MOUNAlae/dai-comp-001-duct-air-inlet/images/03_demi_coquille_upper.png

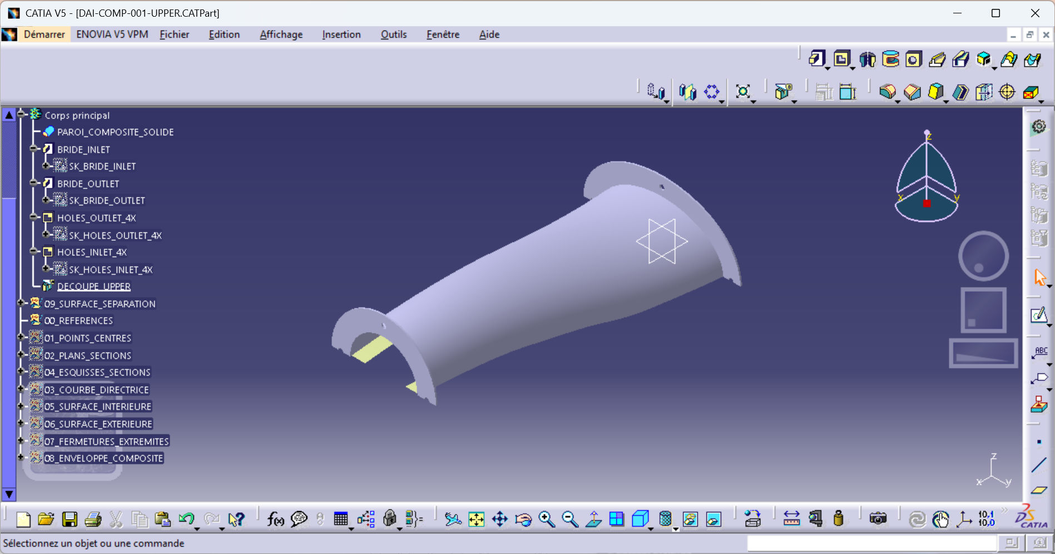
images/03_demi_coquille_upper.png
