MOUNAlae/dai-comp-001-duct-air-inlet/images/04_demi_coquille_lower.png

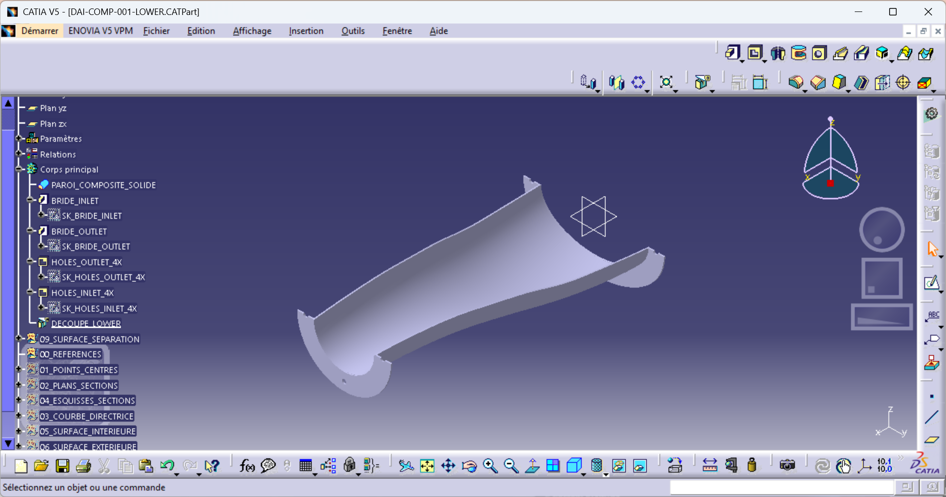
images/04_demi_coquille_lower.png
