MOUNAlae/dai-comp-001-duct-air-inlet/images/06_controle_interferences.png

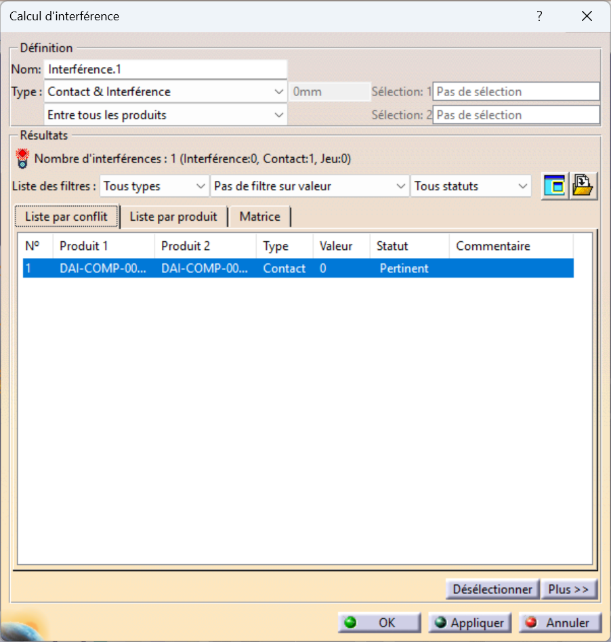
images/06_controle_interferences.png
