MOUNAlae/dai-comp-001-duct-air-inlet/images/07_mise_en_plan_generale.png

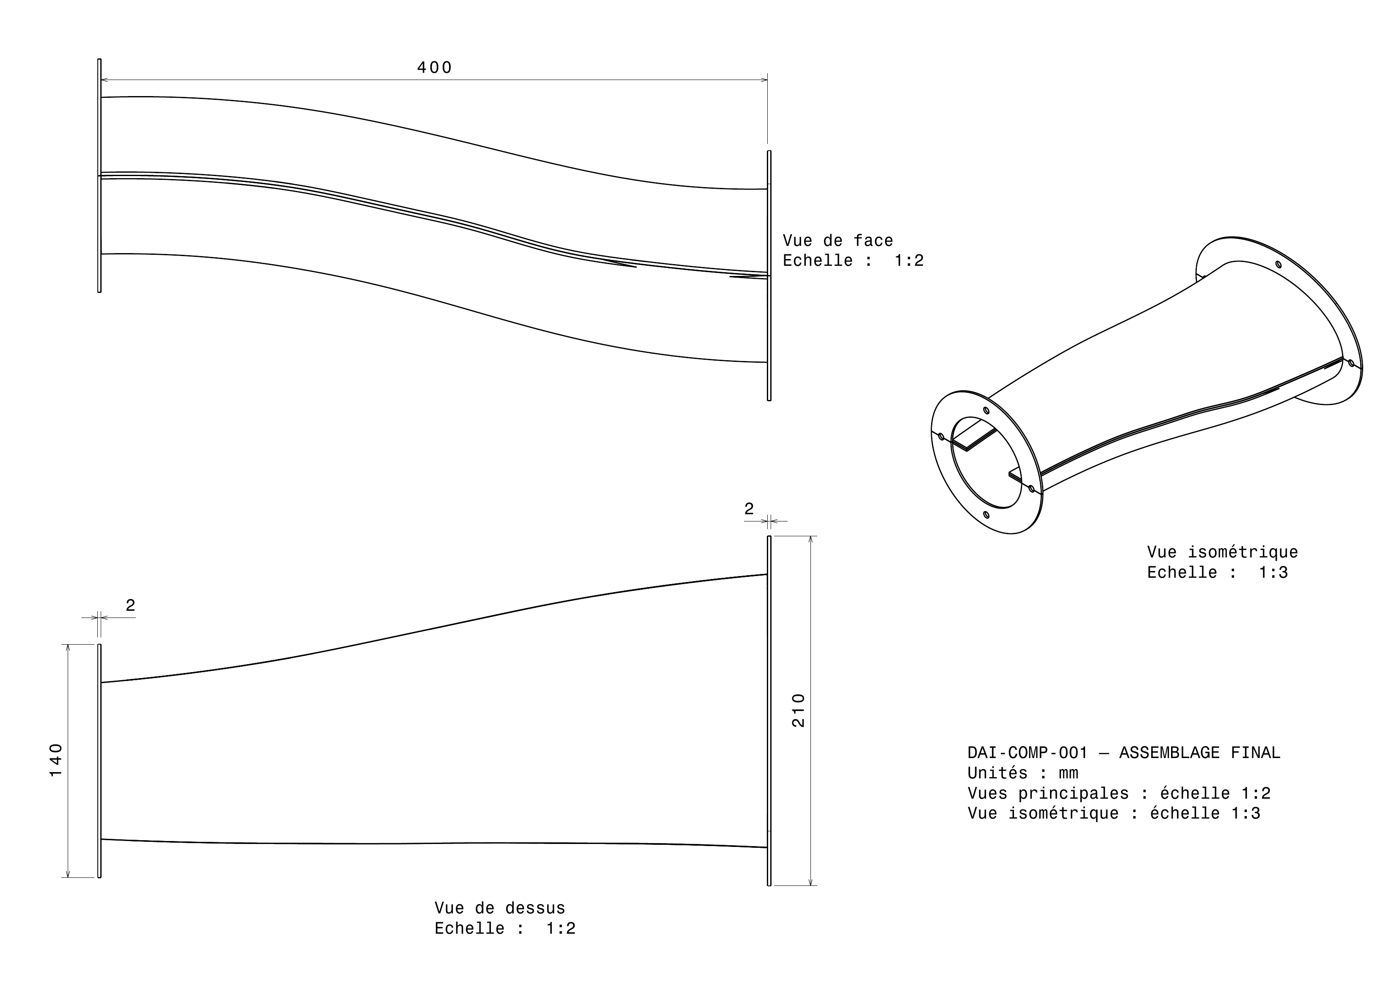
images/07_mise_en_plan_generale.png
