MOUNAlae/dai-comp-001-duct-air-inlet/quality-data/results/DAI_COMP_001_Analyse_Qualite_Final.xlsx

Sheet: 01_PARAMETRES
CODE_PARAMETRE | PARAMETRE | VALEUR | UNITE_OU_COMMENTAIRE
PROJET_ID | Identifiant du projet | DAI-COMP-001 | -
TYPE_DONNEES | Type de données | Synthétiques | Hypothèses pédagogiques
ARCHITECTURE | Architecture du conduit | Deux demi-coquilles UPPER et LOWER | Assemblées par collage
LONGUEUR | Longueur du conduit | 400 | mm
ENTREE_GRAND_AXE | Grand axe de l’entrée | 160 | mm
ENTREE_PETIT_AXE | Petit axe de l’entrée | 100 | mm
SORTIE_DIAMETRE | Diamètre de sortie | 90 | mm
EPAISSEUR_NOMINALE | Épaisseur nominale | 2 | mm
EPAISSEUR_TOLERANCE | Tolérance sur l’épaisseur | 0.2 | mm
PLANEITE_ENTREE_MAX | Planéité maximale de la bride d’entrée | 0.5 | mm
PLANEITE_SORTIE_MAX | Planéité maximale de la bride de sortie | 0.4 | mm
NB_TROUS_INTERFACE | Nombre de trous par interface | 4 | trous
DIAMETRE_TROU | Diamètre nominal des trous | 6.5 | mm
STRATIFICATION | Séquence de stratification | [0/+45/-45/90]s | -
NB_PLIS | Nombre nominal de plis | 8 | plis
NB_JOINTS_LONGITUDINAUX | Nombre de joints longitudinaux | 2 | Joints continus
ECART_PROFIL_MAX_TOLERANCE | Écart maximal admissible du profil intérieur | 1 | mm - hypothèse pédagogique
ECART_POSITION_TROUS_MAX_TOLERANCE | Écart maximal admissible de position des trous | 0.5 | mm - hypothèse pédagogique
PRESSION_TEST_ETANCHEITE | Pression du test pédagogique d’étanchéité | 20 | kPa
DUREE_TEST_ETANCHEITE | Durée du test pédagogique d’étanchéité | 60 | s
TAUX_FUITE_MAX | Indice maximal pédagogique de fuite | 0.5 | kPa/min
DEFINITION_TAUX_FUITE | Définition de l’indice de fuite | Chute de pression équivalente par minute | Méthode pédagogique non industrielle

Sheet: 02_DATASET
ID_PIECE | ORDRE_PRODUCTION | SCENARIO | DATE_FABRICATION | ID_UPPER | ID_LOWER | LOT_PREIMPREGNE | LOT_ADHESIF | MOULE_UPPER | MOULE_LOWER | OPERATEUR_DRAPAGE | OPERATEUR_ASSEMBLAGE | CYCLE_CUISSON | PRESSION_VIDE_ABS_MBAR | TEMP_MAX_C | TEMPS_MAINTIEN_MIN | TEMP_DEMOULAGE_C | RATIO_ADHESIF | TEMPS_OUVERT_MIN | EPAISSEUR_MOY_MM | PLANEITE_ENTREE_MM | PLANEITE_SORTIE_MM | DIAMETRE_TROU_MOY_MM | ECART_PROFIL_MAX_MM | ECART_POSITION_TROUS_MAX_MM | PRESSION_TEST_KPA | DUREE_TEST_S | TAUX_FUITE | JOINT_CONTINU_CONFORME | DEFAUT_PRINCIPAL | NB_DEFAUTS | STATUT_FINAL | COMMENTAIRE
DAI-0001 | 1 | INITIAL | 2026-01-05 | UP-0001 | LO-0001 | PRE-01 | ADH-01 | MU-01 | ML-01 | OP-D01 | OP-A01 | CYC-001 | 100.8 | 122.4 | 87.6 | 64.4 | 1.013 | 42.4 | 2.11 | 0.38 | 0.38 | 6.57 | 0.64 | 0.31 | 20 | 60 | 0.38 | OUI | AUCUN | 0 | CONFORME
DAI-0002 | 2 | INITIAL | 2026-01-06 | UP-0002 | LO-0002 | PRE-01 | ADH-01 | MU-02 | ML-02 | OP-D02 | OP-A02 | CYC-001 | 113.7 | 121.8 | 88.4 | 66.4 | 0.993 | 28.2 | 1.81 | 0.54 | 0.46 | 6.51 | 0.57 | 0.34 | 20 | 60 | 0.26 | OUI | VIDE_POROSITE | 1 | NON CONFORME | Critères hors limite : PLANEITE
DAI-0003 | 3 | INITIAL | 2026-01-07 | UP-0003 | LO-0003 | PRE-01 | ADH-01 | MU-01 | ML-01 | OP-D03 | OP-A01 | CYC-001 | 111.6 | 120.3 | 95.3 | 58.4 | 0.962 | 35.1 | 1.98 | 0.39 | 0.26 | 6.51 | 0.65 | 0.23 | 20 | 60 | 0.57 | OUI | ETANCHEITE | 1 | NON CONFORME | Critères hors limite : ETANCHEITE
DAI-0004 | 4 | INITIAL | 2026-01-08 | UP-0004 | LO-0004 | PRE-01 | ADH-01 | MU-02 | ML-02 | OP-D01 | OP-A02 | CYC-001 | 99 | 119.3 | 93.2 | 61 | 1.002 | 32.3 | 1.87 | 0.29 | 0.37 | 6.5 | 0.89 | 0.33 | 20 | 60 | 0.24 | OUI | AUCUN | 0 | CONFORME
DAI-0005 | 5 | INITIAL | 2026-01-09 | UP-0005 | LO-0005 | PRE-01 | ADH-01 | MU-01 | ML-01 | OP-D02 | OP-A01 | CYC-001 | 111.9 | 123.9 | 96.5 | 64.5 | 0.994 | 35.1 | 1.93 | 0.48 | 0.38 | 6.61 | 0.81 | 0.09 | 20 | 60 | 0.53 | NON | COLLAGE | 2 | NON CONFORME | Critères hors limite : ETANCHEITE, COLLAGE
DAI-0006 | 6 | INITIAL | 2026-01-10 | UP-0006 | LO-0006 | PRE-01 | ADH-01 | MU-02 | ML-02 | OP-D03 | OP-A02 | CYC-002 | 130 | 122.2 | 96.7 | 58.1 | 0.998 | 21.9 | 2.1 | 0.53 | 0.39 | 6.46 | 0.77 | 0.17 | 20 | 60 | 0.27 | OUI | VIDE_POROSITE | 1 | NON CONFORME | Critères hors limite : PLANEITE
DAI-0007 | 7 | INITIAL | 2026-01-11 | UP-0007 | LO-0007 | PRE-01 | ADH-01 | MU-01 | ML-01 | OP-D01 | OP-A01 | CYC-002 | 114.8 | 121.8 | 94.2 | 58.8 | 1.044 | 36.2 | 2.09 | 0.43 | 0.27 | 6.51 | 0.62 | 0.25 | 20 | 60 | 0.45 | OUI | AUCUN | 0 | CONFORME
DAI-0008 | 8 | INITIAL | 2026-01-12 | UP-0008 | LO-0008 | PRE-01 | ADH-01 | MU-02 | ML-02 | OP-D02 | OP-A02 | CYC-002 | 88.8 | 121.6 | 87.2 | 55.7 | 0.981 | 35.1 | 1.97 | 0.34 | 0.27 | 6.52 | 0.65 | 0.38 | 20 | 60 | 0.44 | OUI | AUCUN | 0 | CONFORME
DAI-0009 | 9 | INITIAL | 2026-01-13 | UP-0009 | LO-0009 | PRE-01 | ADH-01 | MU-01 | ML-01 | OP-D03 | OP-A01 | CYC-002 | 106.8 | 121.7 | 86.9 | 64.1 | 1.03 | 23.5 | 1.91 | 0.53 | 0.38 | 6.47 | 0.84 | 0.21 | 20 | 60 | 0.43 | OUI | PLANEITE | 1 | NON CONFORME | Critères hors limite : PLANEITE
DAI-0010 | 10 | INITIAL | 2026-01-14 | UP-0010 | LO-0010 | PRE-01 | ADH-01 | MU-02 | ML-02 | OP-D01 | OP-A02 | CYC-002 | 130 | 118 | 94.7 | 54.5 | 0.999 | 29.3 | 1.99 | 0.48 | 0.21 | 6.45 | 0.91 | 0.26 | 20 | 60 | 0.18 | OUI | AUCUN | 0 | CONFORME
DAI-0011 | 11 | INITIAL | 2026-01-15 | UP-0011 | LO-0011 | PRE-01 | ADH-01 | MU-01 | ML-01 | OP-D02 | OP-A01 | CYC-003 | 105.2 | 121.2 | 91.2 | 60.8 | 1.027 | 40.2 | 2.01 | 0.35 | 0.33 | 6.44 | 0.62 | 0.14 | 20 | 60 | 0.53 | OUI | ETANCHEITE | 1 | NON CONFORME | Critères hors limite : ETANCHEITE
DAI-0012 | 12 | INITIAL | 2026-01-16 | UP-0012 | LO-0012 | PRE-01 | ADH-01 | MU-02 | ML-02 | OP-D03 | OP-A02 | CYC-003 | 97.7 | 122.9 | 93.3 | 63.7 | 0.967 | 35.6 | 2.1 | 0.33 | 0.37 | 6.56 | 0.46 | 0.29 | 20 | 60 | 0.69 | NON | COLLAGE | 2 | NON CONFORME | Critères hors limite : ETANCHEITE, COLLAGE
DAI-0013 | 13 | INITIAL | 2026-01-17 | UP-0013 | LO-0013 | PRE-01 | ADH-01 | MU-01 | ML-01 | OP-D01 | OP-A01 | CYC-003 | 104 | 120.8 | 86.3 | 52.4 | 1.013 | 36.7 | 1.88 | 0.33 | 0.24 | 6.56 | 0.75 | 0.27 | 20 | 60 | 0.21 | OUI | AUCUN | 0 | CONFORME
DAI-0014 | 14 | INITIAL | 2026-01-18 | UP-0014 | LO-0014 | PRE-01 | ADH-01 | MU-02 | ML-02 | OP-D02 | OP-A02 | CYC-003 | 102.3 | 122.6 | 93.4 | 65.4 | 0.984 | 37.7 | 1.89 | 0.45 | 0.33 | 6.53 | 0.73 | 0.39 | 20 | 60 | 0.61 | NON | COLLAGE | 2 | NON CONFORME | Critères hors limite : ETANCHEITE, COLLAGE
DAI-0015 | 15 | INITIAL | 2026-01-19 | UP-0015 | LO-0015 | PRE-01 | ADH-01 | MU-01 | ML-01 | OP-D03 | OP-A01 | CYC-003 | 117 | 122.3 | 96.9 | 61.2 | 0.953 | 25.1 | 1.89 | 0.33 | 0.41 | 6.49 | 0.67 | 0.31 | 20 | 60 | 0.49 | OUI | VIDE_POROSITE | 1 | NON CONFORME | Critères hors limite : PLANEITE
DAI-0016 | 16 | INITIAL | 2026-01-20 | UP-0016 | LO-0016 | PRE-01 | ADH-01 | MU-02 | ML-02 | OP-D01 | OP-A02 | CYC-004 | 89.3 | 120.2 | 90.8 | 63.5 | 0.97 | 24.1 | 2.17 | 0.37 | 0.37 | 6.49 | 0.43 | 0.4 | 20 | 60 | 0.49 | OUI | AUCUN | 0 | CONFORME
DAI-0017 | 17 | INITIAL | 2026-01-21 | UP-0017 | LO-0017 | PRE-01 | ADH-01 | MU-01 | ML-01 | OP-D02 | OP-A01 | CYC-004 | 100.6 | 119.5 | 86.6 | 70 | 0.986 | 35.9 | 2.05 | 0.55 | 0.23 | 6.53 | 0.74 | 0.19 | 20 | 60 | 0.61 | OUI | ETANCHEITE | 2 | NON CONFORME | Critères hors limite : PLANEITE, ETANCHEITE
DAI-0018 | 18 | INITIAL | 2026-01-22 | UP-0018 | LO-0018 | PRE-01 | ADH-01 | MU-02 | ML-02 | OP-D03 | OP-A02 | CYC-004 | 109.2 | 123.3 | 90.7 | 62.4 | 1.024 | 32.7 | 1.88 | 0.52 | 0.28 | 6.46 | 0.71 | 0.05 | 20 | 60 | 0.28 | OUI | PLANEITE | 1 | NON CONFORME | Critères hors limite : PLANEITE
DAI-0019 | 19 | INITIAL | 2026-01-23 | UP-0019 | LO-0019 | PRE-01 | ADH-01 | MU-01 | ML-01 | OP-D01 | OP-A01 | CYC-004 | 115.3 | 121.4 | 87.6 | 65.9 | 1.004 | 28.6 | 1.92 | 0.48 | 0.38 | 6.51 | 0.8 | 0.28 | 20 | 60 | 0.16 | OUI | AUCUN | 0 | CONFORME
DAI-0020 | 20 | INITIAL | 2026-01-24 | UP-0020 | LO-0020 | PRE-01 | ADH-01 | MU-02 | ML-02 | OP-D02 | OP-A02 | CYC-004 | 105.1 | 120.5 | 98.7 | 60.6 | 0.994 | 31.5 | 1.99 | 0.26 | 0.31 | 6.62 | 0.44 | 0.21 | 20 | 60 | 0.39 | OUI | AUCUN | 0 | CONFORME
DAI-0021 | 21 | INITIAL | 2026-01-25 | UP-0021 | LO-0021 | PRE-02 | ADH-01 | MU-01 | ML-01 | OP-D03 | OP-A01 | CYC-005 | 89.5 | 122.5 | 92.6 | 56.7 | 0.979 | 32.4 | 2.1 | 0.36 | 0.25 | 6.48 | 0.44 | 0.19 | 20 | 60 | 0.45 | OUI | AUCUN | 0 | CONFORME
DAI-0022 | 22 | INITIAL | 2026-01-26 | UP-0022 | LO-0022 | PRE-02 | ADH-01 | MU-02 | ML-02 | OP-D01 | OP-A02 | CYC-005 | 96.3 | 122.6 | 90.5 | 62.9 | 0.995 | 33.4 | 2.1 | 0.46 | 0.26 | 6.55 | 1 | 0.22 | 20 | 60 | 0.35 | OUI | AUCUN | 0 | CONFORME
DAI-0023 | 23 | INITIAL | 2026-01-27 | UP-0023 | LO-0023 | PRE-02 | ADH-01 | MU-01 | ML-01 | OP-D02 | OP-A01 | CYC-005 | 96.8 | 123.8 | 85 | 50 | 1.007 | 32.5 | 1.95 | 0.27 | 0.26 | 6.49 | 0.93 | 0.41 | 20 | 60 | 0.35 | OUI | AUCUN | 0 | CONFORME
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
DAI-0100 | 100 | AMELIORE | 2026-04-14 | UP-0100 | LO-0100 | PRE-05 | ADH-04 | MU-02 | ML-02 | OP-D01 | OP-A02 | CYC-020 | 65 | 120.6 | 88.2 | 53.1 | 0.991 | 24.3 | 1.96 | 0.27 | 0.2 | 6.5 | 0.39 | 0.22 | 20 | 60 | 0.05 | OUI | AUCUN | 0 | CONFORME

Sheet: 03_DICTIONNAIRE
NOM_VARIABLE | DESCRIPTION | TYPE_DONNEE | UNITE_OU_FORMAT | REGLE_OU_VALEURS
ID_PIECE | Identifiant unique du conduit | Texte | DAI-0001, DAI-0002... | Unique et obligatoire
ORDRE_PRODUCTION | Ordre chronologique de fabrication | Entier | 1, 2, 3... | Strictement positif
SCENARIO | État du procédé | Texte | INITIAL ou AMELIORE | Valeur contrôlée
DATE_FABRICATION | Date pédagogique de fabrication | Date | JJ/MM/AAAA | Date synthétique
ID_UPPER | Identifiant de la demi-coquille supérieure | Texte | UP-0001... | Obligatoire
ID_LOWER | Identifiant de la demi-coquille inférieure | Texte | LO-0001... | Obligatoire
LOT_PREIMPREGNE | Lot de matière préimprégnée | Texte | PRE-01... | Traçabilité matière
LOT_ADHESIF | Lot de l’adhésif | Texte | ADH-01... | Traçabilité collage
MOULE_UPPER | Identifiant du moule supérieur | Texte | MU-01... | Valeur contrôlée
MOULE_LOWER | Identifiant du moule inférieur | Texte | ML-01... | Valeur contrôlée
OPERATEUR_DRAPAGE | Opérateur réalisant le drapage | Texte | OP-D01... | Donnée synthétique
OPERATEUR_ASSEMBLAGE | Opérateur réalisant l’assemblage | Texte | OP-A01... | Donnée synthétique
CYCLE_CUISSON | Identifiant du cycle de cuisson | Texte | CYC-01... | Traçabilité du cycle
PRESSION_VIDE_ABS_MBAR | Pression absolue mesurée sous vide | Décimal | mbar | Valeur positive
TEMP_MAX_C | Température maximale du cycle | Décimal | °C | Valeur synthétique
TEMPS_MAINTIEN_MIN | Durée du palier thermique | Décimal | min | Valeur synthétique
TEMP_DEMOULAGE_C | Température au démoulage | Décimal | °C | Valeur synthétique
RATIO_ADHESIF | Ratio pédagogique du mélange adhésif | Décimal | rapport | Valeur synthétique
TEMPS_OUVERT_MIN | Durée entre préparation et fermeture du collage | Décimal | min | Valeur synthétique
EPAISSEUR_MOY_MM | Épaisseur moyenne du conduit | Décimal | mm | Spécification 2,0 ± 0,2 mm
PLANEITE_ENTREE_MM | Défaut de planéité de la bride d’entrée | Décimal | mm | Maximum 0,5 mm
PLANEITE_SORTIE_MM | Défaut de planéité de la bride de sortie | Décimal | mm | Maximum 0,4 mm
DIAMETRE_TROU_MOY_MM | Diamètre moyen des trous | Décimal | mm | Nominal 6,5 mm
ECART_PROFIL_MAX_MM | Écart maximal du profil intérieur | Décimal | mm | Maximum pédagogique 1,0 mm
ECART_POSITION_TROUS_MAX_MM | Écart maximal de position des centres de trous par rapport aux références | Décimal | mm | Maximum pédagogique 0,5 mm
PRESSION_TEST_KPA | Pression appliquée pendant le test pédagogique d’étanchéité | Décimal | kPa | Valeur fixée à 20 kPa
DUREE_TEST_S | Durée du test pédagogique d’étanchéité | Décimal | s | Valeur fixée à 60 s
TAUX_FUITE | Indice pédagogique obtenu par décroissance de pression | Décimal | kPa/min | Maximum pédagogique 0,5 kPa/min
JOINT_CONTINU_CONFORME | Conformité visuelle des deux joints | Texte | OUI ou NON | Contrôle 100 %
DEFAUT_PRINCIPAL | Défaut dominant constaté | Texte | Catégorie de défaut | AUCUN si pièce conforme
NB_DEFAUTS | Nombre de défauts relevés | Entier | nombre | Minimum 0
STATUT_FINAL | Décision finale de conformité | Texte | CONFORME ou NON CONFORME | Calculé ultérieurement
COMMENTAIRE | Remarque complémentaire | Texte | Texte libre | Facultatif

Sheet: 04_REGLES_GENERATION
VARIABLE | REGLE_SCENARIO_INITIAL | REGLE_SCENARIO_AMELIORE | FORMAT_OU_PLAGE | STATUT
ID_PIECE | Numérotation séquentielle | Numérotation séquentielle | DAI-0001, DAI-0002... | Défini
ORDRE_PRODUCTION | Ordre 1 à 50 | Ordre 51 à 100 | Entier positif | Défini
SCENARIO | INITIAL | AMELIORE | Liste contrôlée | Défini
DATE_FABRICATION | Dates synthétiques consécutives | Dates synthétiques consécutives | JJ/MM/AAAA | Défini
ID_UPPER | Identifiant unique | Identifiant unique | UP-0001... | Défini
ID_LOWER | Identifiant unique | Identifiant unique | LO-0001... | Défini
LOT_PREIMPREGNE | Changement tous les 20 conduits | Changement tous les 20 conduits | PRE-01, PRE-02... | Défini
LOT_ADHESIF | Changement tous les 25 conduits | Changement tous les 25 conduits | ADH-01, ADH-02... | Défini
MOULE_UPPER | Alternance MU-01 et MU-02 | Alternance MU-01 et MU-02 | MU-01 ou MU-02 | Défini
MOULE_LOWER | Alternance ML-01 et ML-02 | Alternance ML-01 et ML-02 | ML-01 ou ML-02 | Défini
OPERATEUR_DRAPAGE | Répartition entre 3 opérateurs | Répartition entre 3 opérateurs | OP-D01 à OP-D03 | Défini
OPERATEUR_ASSEMBLAGE | Répartition entre 2 opérateurs | Répartition entre 2 opérateurs | OP-A01 ou OP-A02 | Défini
CYCLE_CUISSON | Identifiant de lot de cuisson | Identifiant de lot de cuisson | CYC-001... | Défini
PRESSION_VIDE_ABS_MBAR | Valeur entre 70 et 130 | Valeur entre 60 et 90 | mbar, 1 décimale | Hypothèse pédagogique
TEMP_MAX_C | Valeur entre 118 et 124 | Valeur entre 120 et 122 | °C, 1 décimale | Hypothèse pédagogique
TEMPS_MAINTIEN_MIN | Valeur entre 85 et 100 | Valeur entre 88 et 92 | min, 1 décimale | Hypothèse pédagogique
TEMP_DEMOULAGE_C | Valeur entre 50 et 70 | Valeur entre 50 et 60 | °C, 1 décimale | Hypothèse pédagogique
RATIO_ADHESIF | Valeur entre 0,95 et 1,05 | Valeur entre 0,98 et 1,02 | Ratio normalisé autour de 1,00 | Hypothèse pédagogique
TEMPS_OUVERT_MIN | Valeur entre 20 et 45 | Valeur entre 20 et 30 | min, 1 décimale | Hypothèse pédagogique
EPAISSEUR_MOY_MM | Dispersion importante autour de 2,0 | Dispersion réduite autour de 2,0 | Spécification 1,8 à 2,2 mm | Défini
PLANEITE_ENTREE_MM | Dispersion pouvant dépasser 0,5 | Dispersion principalement inférieure à 0,5 | Maximum 0,5 mm | Défini
PLANEITE_SORTIE_MM | Dispersion pouvant dépasser 0,4 | Dispersion principalement inférieure à 0,4 | Maximum 0,4 mm | Défini
DIAMETRE_TROU_MOY_MM | Dispersion autour de 6,5 | Dispersion réduite autour de 6,5 | mm, 2 décimales | Nominal défini
ECART_PROFIL_MAX_MM | Valeur entre 0,40 et 1,40 | Valeur entre 0,20 et 0,90 | Maximum pédagogique 1,00 mm | Hypothèse pédagogique définie
ECART_POSITION_TROUS_MAX_MM | Valeur entre 0,15 et 0,80 | Valeur entre 0,10 et 0,45 | Maximum pédagogique 0,50 mm | Hypothèse pédagogique définie
PRESSION_TEST_KPA | Valeur fixe 20 | Valeur fixe 20 | kPa | Hypothèse pédagogique définie
DUREE_TEST_S | Valeur fixe 60 | Valeur fixe 60 | s | Hypothèse pédagogique définie
TAUX_FUITE | Valeur entre 0,10 et 0,90 | Valeur entre 0,05 et 0,45 | Maximum pédagogique 0,50 kPa/min | Hypothèse pédagogique définie
JOINT_CONTINU_CONFORME | Probabilité de NON plus élevée | Probabilité de OUI plus élevée | OUI ou NON | Défini
DEFAUT_PRINCIPAL | AUCUN, PLANEITE, EPAISSEUR, VIDE_POROSITE, COLLAGE, PERCAGE, PROFIL ou ETANCHEITE | Mêmes catégories avec fréquence réduite | Texte contrôlé | Défini
NB_DEFAUTS | Calculé selon les contrôles non conformes | Calculé selon les contrôles non conformes | Entier supérieur ou égal à 0 | Calculé ultérieurement
STATUT_FINAL | Calculé à partir des spécifications | Calculé à partir des spécifications | CONFORME ou NON CONFORME | Calculé ultérieurement
COMMENTAIRE | Remarque facultative | Remarque facultative | Texte libre | Défini

Sheet: 05_SYNTHESE_J60
SCENARIO | TOTAL_PIECES | PIECES_CONFORMES | PIECES_NON_CONFORMES | TAUX_CONFORMITE_PCT | TAUX_NON_CONFORMITE_PCT
INITIAL | 50 | 26 | 24 | 52 | 48
AMELIORE | 50 | 47 | 3 | 94 | 6
GLOBAL | 100 | 73 | 27 | 73 | 27

Sheet: 06_PARETO_J60
DEFAUT_PRINCIPAL | NOMBRE_PIECES | CUMUL_PCT | POURCENTAGE_PCT | INITIAL | AMELIORE | RANG
COLLAGE | 11 | 40.74 | 40.74 | 8 | 3 | 1
VIDE_POROSITE | 5 | 59.26 | 18.52 | 5 | 0 | 2
ETANCHEITE | 4 | 74.07 | 14.81 | 4 | 0 | 3
PLANEITE | 4 | 88.89 | 14.81 | 4 | 0 | 4
EPAISSEUR | 1 | 92.59 | 3.7 | 1 | 0 | 5
PERCAGE | 1 | 96.3 | 3.7 | 1 | 0 | 6
PROFIL | 1 | 100 | 3.7 | 1 | 0 | 7

Sheet: 07_MSA_MESURES_J61
SERIE | OPERATEUR | REPETITION | POSITION_ORDRE | PIECE | VALEUR_REFERENCE_MM | MESURE_PLANEITE_MM | TYPE_DONNEE
S1 | A | 1 | 1 | P09 | 0.41 | 0.41 | SYNTHETIQUE
S1 | A | 1 | 2 | P07 | 0.35 | 0.34 | SYNTHETIQUE
S1 | A | 1 | 3 | P02 | 0.19 | 0.18 | SYNTHETIQUE
S1 | A | 1 | 4 | P04 | 0.26 | 0.26 | SYNTHETIQUE
S1 | A | 1 | 5 | P05 | 0.29 | 0.29 | SYNTHETIQUE
S1 | A | 1 | 6 | P01 | 0.16 | 0.15 | SYNTHETIQUE
S1 | A | 1 | 7 | P03 | 0.23 | 0.22 | SYNTHETIQUE
S1 | A | 1 | 8 | P08 | 0.38 | 0.38 | SYNTHETIQUE
S1 | A | 1 | 9 | P06 | 0.32 | 0.32 | SYNTHETIQUE
S1 | A | 1 | 10 | P10 | 0.45 | 0.45 | SYNTHETIQUE
S2 | A | 2 | 1 | P03 | 0.23 | 0.24 | SYNTHETIQUE
S2 | A | 2 | 2 | P05 | 0.29 | 0.28 | SYNTHETIQUE
S2 | A | 2 | 3 | P01 | 0.16 | 0.14 | SYNTHETIQUE
S2 | A | 2 | 4 | P10 | 0.45 | 0.45 | SYNTHETIQUE
S2 | A | 2 | 5 | P07 | 0.35 | 0.34 | SYNTHETIQUE
S2 | A | 2 | 6 | P09 | 0.41 | 0.41 | SYNTHETIQUE
S2 | A | 2 | 7 | P08 | 0.38 | 0.39 | SYNTHETIQUE
S2 | A | 2 | 8 | P02 | 0.19 | 0.19 | SYNTHETIQUE
S2 | A | 2 | 9 | P04 | 0.26 | 0.25 | SYNTHETIQUE
S2 | A | 2 | 10 | P06 | 0.32 | 0.31 | SYNTHETIQUE
S3 | B | 1 | 1 | P01 | 0.16 | 0.16 | SYNTHETIQUE
S3 | B | 1 | 2 | P02 | 0.19 | 0.18 | SYNTHETIQUE
S3 | B | 1 | 3 | P08 | 0.38 | 0.39 | SYNTHETIQUE
S3 | B | 1 | 4 | P03 | 0.23 | 0.23 | SYNTHETIQUE
S3 | B | 1 | 5 | P07 | 0.35 | 0.34 | SYNTHETIQUE
S3 | B | 1 | 6 | P10 | 0.45 | 0.45 | SYNTHETIQUE
S3 | B | 1 | 7 | P09 | 0.41 | 0.42 | SYNTHETIQUE
S3 | B | 1 | 8 | P05 | 0.29 | 0.29 | SYNTHETIQUE
S3 | B | 1 | 9 | P06 | 0.32 | 0.32 | SYNTHETIQUE
S3 | B | 1 | 10 | P04 | 0.26 | 0.27 | SYNTHETIQUE
S4 | B | 2 | 1 | P03 | 0.23 | 0.23 | SYNTHETIQUE
S4 | B | 2 | 2 | P07 | 0.35 | 0.35 | SYNTHETIQUE
S4 | B | 2 | 3 | P01 | 0.16 | 0.15 | SYNTHETIQUE
S4 | B | 2 | 4 | P06 | 0.32 | 0.33 | SYNTHETIQUE
S4 | B | 2 | 5 | P09 | 0.41 | 0.41 | SYNTHETIQUE
S4 | B | 2 | 6 | P02 | 0.19 | 0.19 | SYNTHETIQUE
S4 | B | 2 | 7 | P10 | 0.45 | 0.45 | SYNTHETIQUE
S4 | B | 2 | 8 | P04 | 0.26 | 0.27 | SYNTHETIQUE
S4 | B | 2 | 9 | P08 | 0.38 | 0.37 | SYNTHETIQUE
S4 | B | 2 | 10 | P05 | 0.29 | 0.3 | SYNTHETIQUE
S5 | C | 1 | 1 | P04 | 0.26 | 0.26 | SYNTHETIQUE
S5 | C | 1 | 2 | P09 | 0.41 | 0.4 | SYNTHETIQUE
S5 | C | 1 | 3 | P08 | 0.38 | 0.37 | SYNTHETIQUE
S5 | C | 1 | 4 | P02 | 0.19 | 0.19 | SYNTHETIQUE
S5 | C | 1 | 5 | P07 | 0.35 | 0.35 | SYNTHETIQUE
S5 | C | 1 | 6 | P05 | 0.29 | 0.3 | SYNTHETIQUE
S5 | C | 1 | 7 | P03 | 0.23 | 0.23 | SYNTHETIQUE
S5 | C | 1 | 8 | P06 | 0.32 | 0.32 | SYNTHETIQUE
S5 | C | 1 | 9 | P10 | 0.45 | 0.45 | SYNTHETIQUE
S5 | C | 1 | 10 | P01 | 0.16 | 0.16 | SYNTHETIQUE
S6 | C | 2 | 1 | P10 | 0.45 | 0.46 | SYNTHETIQUE
S6 | C | 2 | 2 | P02 | 0.19 | 0.19 | SYNTHETIQUE
S6 | C | 2 | 3 | P07 | 0.35 | 0.35 | SYNTHETIQUE
S6 | C | 2 | 4 | P01 | 0.16 | 0.16 | SYNTHETIQUE
S6 | C | 2 | 5 | P03 | 0.23 | 0.23 | SYNTHETIQUE
S6 | C | 2 | 6 | P05 | 0.29 | 0.29 | SYNTHETIQUE
S6 | C | 2 | 7 | P04 | 0.26 | 0.27 | SYNTHETIQUE
S6 | C | 2 | 8 | P08 | 0.38 | 0.38 | SYNTHETIQUE
S6 | C | 2 | 9 | P06 | 0.32 | 0.33 | SYNTHETIQUE
S6 | C | 2 | 10 | P09 | 0.41 | 0.4 | SYNTHETIQUE

Sheet: 08_MSA_ANOVA_J61
SOURCE | SOMME_CARRES_SS | DEGRES_LIBERTE_DF | CARRE_MOYEN_MS | F
PIECE | 0.505215 | 9 | 0.056135 | 1086.4839
OPERATEUR | 0.00030333 | 2 | 0.00015167 | 2.9355
PIECE_X_OPERATEUR | 0.00093 | 18 | 5.167e-05 | 1.24
REPETABILITE | 0.00125 | 30 | 4.167e-05
TOTAL | 0.50769833 | 59

Sheet: 09_MSA_COMPOSANTES_J61
SOURCE | VARIANCE | ECART_TYPE_SIGMA | VARIATION_ETUDE_6_SIGMA_MM | CONTRIBUTION_PCT | STUDY_VARIATION_PCT
REPETABILITE_EV | 4.167e-05 | 0.006455 | 0.03873 | 0.44 | 6.66
OPERATEUR | 5e-06 | 0.002236 | 0.013416 | 0.05 | 2.31
INTERACTION_PIECE_OPERATEUR | 5e-06 | 0.002236 | 0.013416 | 0.05 | 2.31
REPRODUCTIBILITE_AV | 1e-05 | 0.003162 | 0.018974 | 0.11 | 3.26
GAGE_RR_TOTAL | 5.167e-05 | 0.007188 | 0.043128 | 0.55 | 7.41
PIECE_A_PIECE_PV | 0.00934722 | 0.096681 | 0.580086 | 99.45 | 99.72
VARIATION_TOTALE_TV | 0.00939889 | 0.096948 | 0.581687 | 100 | 100

Sheet: 10_MSA_SYNTHESE_J61
INDICATEUR | VALEUR | UNITE | INTERPRETATION
CARACTERISTIQUE | PLANEITE_BRIDE_ENTREE | mm | CTQ-01
TYPE_ETUDE | GAGE_RR_CROISE_ANOVA | - | 10 pièces x 3 opérateurs x 2 répétitions
NOMBRE_MESURES | 60 | mesures | Plan équilibré
POURCENTAGE_GRR_STUDY | 7.41 | % | < 10 % : acceptable
POURCENTAGE_GRR_TOLERANCE | 8.63 | % | Indicateur complémentaire, spécification unilatérale
NDC | 18 | catégories | Minimum attendu : 5
DECISION_MSA | SYSTEME ACCEPTABLE | - | Décision pédagogique
AUTORISATION_SPC_CAPABILITE | OUI | - | Utilisation autorisée pour la suite pédagogique
TYPE_DONNEES | SYNTHETIQUES | - | Aucune validation industrielle revendiquée

Sheet: 11_MSA_MOYENNES_J61
PIECE | REFERENCE_MM | MOYENNE_A_MM | MOYENNE_B_MM | MOYENNE_C_MM | MOYENNE_PIECE_MM
P01 | 0.16 | 0.145 | 0.155 | 0.16 | 0.153
P02 | 0.19 | 0.185 | 0.185 | 0.19 | 0.187
P03 | 0.23 | 0.23 | 0.23 | 0.23 | 0.23
P04 | 0.26 | 0.255 | 0.27 | 0.265 | 0.263
P05 | 0.29 | 0.285 | 0.295 | 0.295 | 0.292
P06 | 0.32 | 0.315 | 0.325 | 0.325 | 0.322
P07 | 0.35 | 0.34 | 0.345 | 0.35 | 0.345
P08 | 0.38 | 0.385 | 0.38 | 0.375 | 0.38
P09 | 0.41 | 0.41 | 0.415 | 0.4 | 0.408
P10 | 0.45 | 0.45 | 0.45 | 0.455 | 0.452

Sheet: 12_SPC_INITIAL_J62
POINT | ID_PIECE | ORDRE_PRODUCTION | DATE_FABRICATION | SCENARIO | PLANEITE_ENTREE_MM | CL_I_MM | UCL_I_MM | LCL_I_MM | ALERTE_I | MR_MM | CL_MR_MM | UCL_MR_MM | LCL_MR_MM | ALERTE_MR
1 | DAI-0001 | 1 | 2026-01-05 | INITIAL | 0.38 | 0.3912 | 0.6745 | 0.1079 | OK |  | 0.1065 | 0.348 | 0
2 | DAI-0002 | 2 | 2026-01-06 | INITIAL | 0.54 | 0.3912 | 0.6745 | 0.1079 | OK | 0.16 | 0.1065 | 0.348 | 0 | OK
3 | DAI-0003 | 3 | 2026-01-07 | INITIAL | 0.39 | 0.3912 | 0.6745 | 0.1079 | OK | 0.15 | 0.1065 | 0.348 | 0 | OK
4 | DAI-0004 | 4 | 2026-01-08 | INITIAL | 0.29 | 0.3912 | 0.6745 | 0.1079 | OK | 0.1 | 0.1065 | 0.348 | 0 | OK
5 | DAI-0005 | 5 | 2026-01-09 | INITIAL | 0.48 | 0.3912 | 0.6745 | 0.1079 | OK | 0.19 | 0.1065 | 0.348 | 0 | OK
6 | DAI-0006 | 6 | 2026-01-10 | INITIAL | 0.53 | 0.3912 | 0.6745 | 0.1079 | OK | 0.05 | 0.1065 | 0.348 | 0 | OK
7 | DAI-0007 | 7 | 2026-01-11 | INITIAL | 0.43 | 0.3912 | 0.6745 | 0.1079 | OK | 0.1 | 0.1065 | 0.348 | 0 | OK
8 | DAI-0008 | 8 | 2026-01-12 | INITIAL | 0.34 | 0.3912 | 0.6745 | 0.1079 | OK | 0.09 | 0.1065 | 0.348 | 0 | OK
9 | DAI-0009 | 9 | 2026-01-13 | INITIAL | 0.53 | 0.3912 | 0.6745 | 0.1079 | OK | 0.19 | 0.1065 | 0.348 | 0 | OK
10 | DAI-0010 | 10 | 2026-01-14 | INITIAL | 0.48 | 0.3912 | 0.6745 | 0.1079 | OK | 0.05 | 0.1065 | 0.348 | 0 | OK
11 | DAI-0011 | 11 | 2026-01-15 | INITIAL | 0.35 | 0.3912 | 0.6745 | 0.1079 | OK | 0.13 | 0.1065 | 0.348 | 0 | OK
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
49 | DAI-0049 | 49 | 2026-02-22 | INITIAL | 0.23 | 0.3912 | 0.6745 | 0.1079 | OK | 0.14 | 0.1065 | 0.348 | 0 | OK
50 | DAI-0050 | 50 | 2026-02-23 | INITIAL | 0.42 | 0.3912 | 0.6745 | 0.1079 | OK | 0.19 | 0.1065 | 0.348 | 0 | OK

Sheet: 13_SPC_AMELIORE_J62
POINT | ID_PIECE | ORDRE_PRODUCTION | DATE_FABRICATION | SCENARIO | PLANEITE_ENTREE_MM | CL_I_MM | UCL_I_MM | LCL_I_MM | ALERTE_I | MR_MM | CL_MR_MM | UCL_MR_MM | LCL_MR_MM | ALERTE_MR
1 | DAI-0051 | 51 | 2026-02-24 | AMELIORE | 0.26 | 0.2422 | 0.4045 | 0.0799 | OK |  | 0.061 | 0.1994 | 0
2 | DAI-0052 | 52 | 2026-02-25 | AMELIORE | 0.24 | 0.2422 | 0.4045 | 0.0799 | OK | 0.02 | 0.061 | 0.1994 | 0 | OK
3 | DAI-0053 | 53 | 2026-02-26 | AMELIORE | 0.21 | 0.2422 | 0.4045 | 0.0799 | OK | 0.03 | 0.061 | 0.1994 | 0 | OK
4 | DAI-0054 | 54 | 2026-02-27 | AMELIORE | 0.18 | 0.2422 | 0.4045 | 0.0799 | OK | 0.03 | 0.061 | 0.1994 | 0 | OK
5 | DAI-0055 | 55 | 2026-02-28 | AMELIORE | 0.25 | 0.2422 | 0.4045 | 0.0799 | OK | 0.07 | 0.061 | 0.1994 | 0 | OK
6 | DAI-0056 | 56 | 2026-03-01 | AMELIORE | 0.25 | 0.2422 | 0.4045 | 0.0799 | OK | 0 | 0.061 | 0.1994 | 0 | OK
7 | DAI-0057 | 57 | 2026-03-02 | AMELIORE | 0.23 | 0.2422 | 0.4045 | 0.0799 | OK | 0.02 | 0.061 | 0.1994 | 0 | OK
8 | DAI-0058 | 58 | 2026-03-03 | AMELIORE | 0.26 | 0.2422 | 0.4045 | 0.0799 | OK | 0.03 | 0.061 | 0.1994 | 0 | OK
9 | DAI-0059 | 59 | 2026-03-04 | AMELIORE | 0.25 | 0.2422 | 0.4045 | 0.0799 | OK | 0.01 | 0.061 | 0.1994 | 0 | OK
10 | DAI-0060 | 60 | 2026-03-05 | AMELIORE | 0.17 | 0.2422 | 0.4045 | 0.0799 | OK | 0.08 | 0.061 | 0.1994 | 0 | OK
11 | DAI-0061 | 61 | 2026-03-06 | AMELIORE | 0.23 | 0.2422 | 0.4045 | 0.0799 | OK | 0.06 | 0.061 | 0.1994 | 0 | OK
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
49 | DAI-0099 | 99 | 2026-04-13 | AMELIORE | 0.17 | 0.2422 | 0.4045 | 0.0799 | OK | 0.09 | 0.061 | 0.1994 | 0 | OK
50 | DAI-0100 | 100 | 2026-04-14 | AMELIORE | 0.27 | 0.2422 | 0.4045 | 0.0799 | OK | 0.1 | 0.061 | 0.1994 | 0 | OK

Sheet: 14_SPC_SYNTHESE_J62
SCENARIO | NOMBRE_PIECES | MOYENNE_I_MM | MOYENNE_MR_MM | SIGMA_ESTIME_MM | LCL_I_MM | UCL_I_MM | LCL_MR_MM | UCL_MR_MM | NB_ALERTES_I | NB_ALERTES_MR | DECISION_SPC | TYPE_DONNEES
INITIAL | 50 | 0.3912 | 0.1065 | 0.0944 | 0.1079 | 0.6745 | 0 | 0.348 | 1 | 1 | PROCEDE INSTABLE | SYNTHETIQUES
AMELIORE | 50 | 0.2422 | 0.061 | 0.0541 | 0.0799 | 0.4045 | 0 | 0.1994 | 0 | 0 | PROCEDE STABLE | SYNTHETIQUES

Sheet: 15_CAPABILITE_J63
SCENARIO | CPK_UNILATERAL | PPK_UNILATERAL | SEUIL_CIBLE | STABILITE_SPC | NOMBRE_PIECES | MOYENNE_MM | SIGMA_WITHIN_MM | SIGMA_OVERALL_MM | USL_MM | NB_HORS_SPEC | TAUX_HORS_SPEC_PCT | DECISION_CAPABILITE | CP_PP_BILATERAUX | INTERPRETATION | TYPE_DONNEES
INITIAL | 0.38 | 0.38 | 1.33 | PROCEDE INSTABLE | 50 | 0.3912 | 0.0944 | 0.095 | 0.5 | 8 | 16 | NON INTERPRETABLE - PROCEDE INSTABLE | NON APPLICABLE | Indices indicatifs uniquement. La stabilité est obligatoire avant conclusion. | SYNTHETIQUES
AMELIORE | 1.59 | 1.79 | 1.33 | PROCEDE STABLE | 50 | 0.2422 | 0.0541 | 0.0481 | 0.5 | 0 | 0 | PROCEDE CAPABLE | NON APPLICABLE | Procédé stable et indices unilatéraux supérieurs ou égaux à 1,33. | SYNTHETIQUES

Sheet: 16_DASHBOARD_J64
SCENARIO | TAUX_CONFORMITE_PCT | TAUX_NON_CONFORMITE_PCT | NB_PIECES_NON_CONFORMES | MOYENNE_PLANEITE_ENTREE_MM | CPK_UNILATERAL | PPK_UNILATERAL | SEUIL_CAPABILITE | NB_HORS_SPEC | NB_ALERTES_SPC_TOTAL | STABILITE_SPC | DECISION_CAPABILITE | TYPE_DONNEES
INITIAL | 52 | 48 | 24 | 0.3912 | 0.38 | 0.38 | 1.33 | 8 | 2 | PROCEDE INSTABLE | NON INTERPRETABLE - PROCEDE INSTABLE | SYNTHETIQUES
AMELIORE | 94 | 6 | 3 | 0.2422 | 1.59 | 1.79 | 1.33 | 0 | 0 | PROCEDE STABLE | PROCEDE CAPABLE | SYNTHETIQUES

Sheet: 17_SYNTHESE_FINALE_J64
SECTION | INDICATEUR | VALEUR | UNITE | INTERPRETATION
PERFORMANCE | GAIN_CONFORMITE | 42 | points | Passage de 52 % à 94 % de pièces conformes.
PERFORMANCE | REDUCTION_PIECES_NON_CONFORMES | 87.5 | % | Passage de 24 à 3 pièces non conformes.
PERFORMANCE | REDUCTION_MOYENNE_PLANEITE | 38.09 | % | Réduction de la moyenne de planéité d’entrée.
PARETO | DEFAUT_PRINCIPAL_1 | COLLAGE | - | 11 pièces, 40,74 % des NC.
PARETO | DEFAUT_PRINCIPAL_2 | VIDE_POROSITE | - | 5 pièces, cumul 59,26 %.
MSA | POURCENTAGE_GRR_STUDY | 7.41 | % | Inférieur à 10 %, système de mesure acceptable.
MSA | POURCENTAGE_GRR_TOLERANCE | 8.63 | % | Indicateur complémentaire unilatéral.
MSA | NDC | 18 | catégories | Supérieur au minimum pédagogique de 5.
MSA | DECISION_MSA | SYSTEME ACCEPTABLE | - | SPC et capabilité autorisés.
SPC | STABILITE_INITIAL | PROCEDE INSTABLE | - | Deux alertes statistiques détectées.
SPC | STABILITE_AMELIORE | PROCEDE STABLE | - | Aucune alerte sur les cartes I-MR.
CAPABILITE | CAPABILITE_INITIAL | NON INTERPRETABLE - PROCEDE INSTABLE | - | Indices indicatifs uniquement, procédé instable.
CAPABILITE | CAPABILITE_AMELIORE | PROCEDE CAPABLE | - | Cpk 1,59 et Ppk 1,79, supérieurs à 1,33.
CONCLUSION | RESULTAT_GLOBAL | AMELIORATION VALIDEE | - | Le scénario amélioré est plus conforme, stable et capable dans le cadre pédagogique.
LIMITES | TYPE_DONNEES | SYNTHETIQUES | - | Aucune validation industrielle ou aéronautique réelle n’est revendiquée.
