MOUNAlae/dai-comp-001-duct-air-inlet/quality-data/results/DAI_COMP_001_Dashboard_KPI.csv

SCENARIO | TAUX_CONFORMITE_PCT | TAUX_NON_CONFORMITE_PCT | NB_PIECES_NON_CONFORMES | MOYENNE_PLANEITE_ENTREE_MM | CPK_UNILATERAL | PPK_UNILATERAL | SEUIL_CAPABILITE | NB_HORS_SPEC | NB_ALERTES_SPC_TOTAL | STABILITE_SPC | DECISION_CAPABILITE | TYPE_DONNEES
INITIAL | 52,00 | 48,00 | 24 | 0,3912 | 0,38 | 0,38 | 1,33 | 8 | 2 | PROCEDE INSTABLE | NON INTERPRETABLE - PROCEDE INSTABLE | SYNTHETIQUES
AMELIORE | 94,00 | 6,00 | 3 | 0,2422 | 1,59 | 1,79 | 1,33 | 0 | 0 | PROCEDE STABLE | PROCEDE CAPABLE | SYNTHETIQUES
