MOUNAlae/dai-comp-001-duct-air-inlet/quality-data/results/DAI_COMP_001_SPC_Synthese.csv

SCENARIO | NOMBRE_PIECES | MOYENNE_I_MM | MOYENNE_MR_MM | SIGMA_ESTIME_MM | LCL_I_MM | UCL_I_MM | LCL_MR_MM | UCL_MR_MM | NB_ALERTES_I | NB_ALERTES_MR | DECISION_SPC | TYPE_DONNEES
INITIAL | 50 | 0,3912 | 0,1065 | 0,0944 | 0,1079 | 0,6745 | 0,0000 | 0,3480 | 1 | 1 | PROCEDE INSTABLE | SYNTHETIQUES
AMELIORE | 50 | 0,2422 | 0,0610 | 0,0541 | 0,0799 | 0,4045 | 0,0000 | 0,1994 | 0 | 0 | PROCEDE STABLE | SYNTHETIQUES
