MOUNAlae/dai-comp-001-duct-air-inlet/cad/DAI-COMP-001-FLUID-DOMAIN.stp

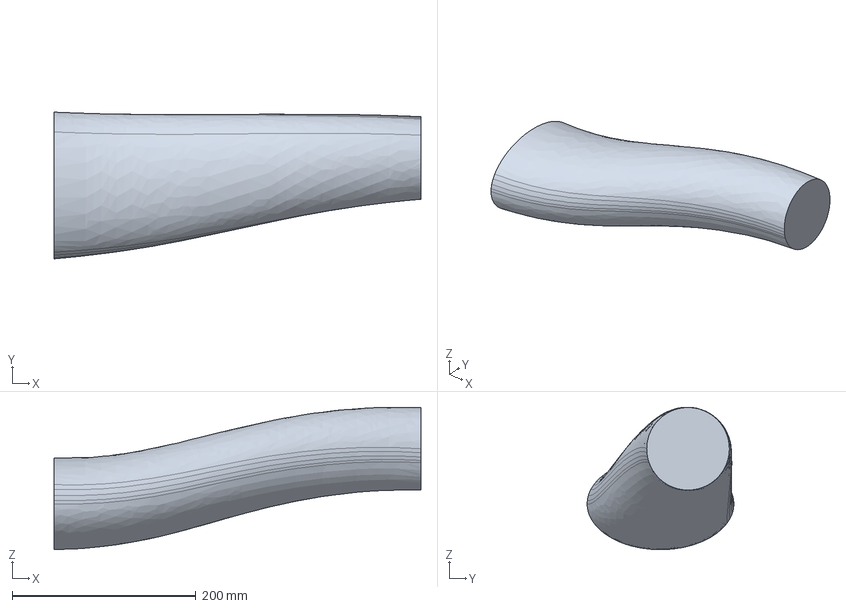
[picture p17: CAD file, 2026-07-29]
cad/DAI-COMP-001-FLUID-DOMAIN.stp
400.0 x 160.0 x 155.2 mm
