MOUNAlae/dai-comp-001-duct-air-inlet/(list of files, cad)

Other CAD files:
cad/DAI-COMP-001-ASSEMBLY.CATProduct
cad/DAI-COMP-001-LOWER.CATPart
cad/DAI-COMP-001-SKELETON.CATPart
cad/DAI-COMP-001-UPPER.CATPart
