MOUNAlae/dai-comp-001-duct-air-inlet/images/02_assemblage_final_catia.png

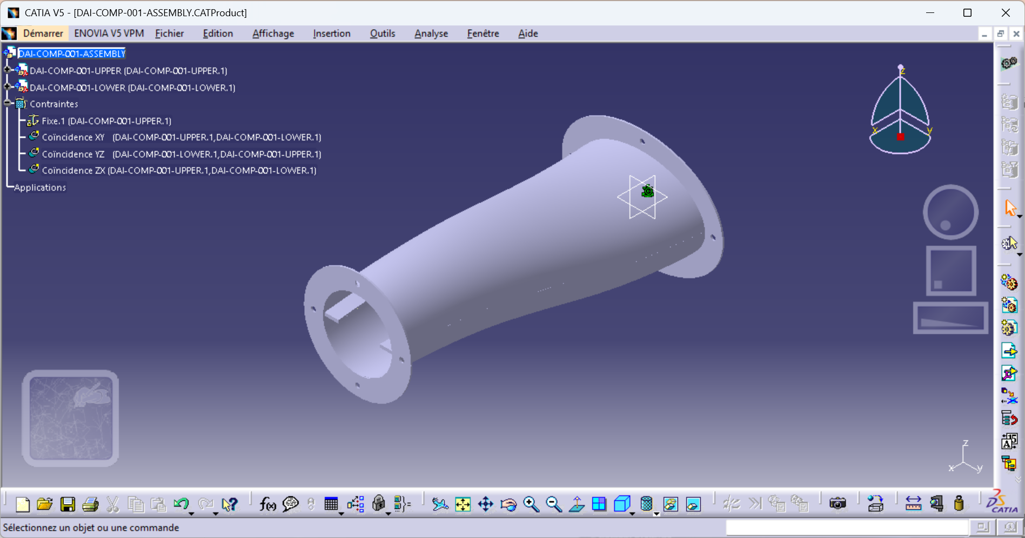
images/02_assemblage_final_catia.png
