MOUNAlae/dai-comp-001-duct-air-inlet/quality-data/results/DAI_COMP_001_Pareto_Defauts.csv

DEFAUT_PRINCIPAL | NOMBRE_PIECES | CUMUL_PCT | POURCENTAGE_PCT | INITIAL | AMELIORE | RANG
COLLAGE | 11 | 40,74 | 40,74 | 8 | 3 | 1
VIDE_POROSITE | 5 | 59,26 | 18,52 | 5 | 0 | 2
ETANCHEITE | 4 | 74,07 | 14,81 | 4 | 0 | 3
PLANEITE | 4 | 88,89 | 14,81 | 4 | 0 | 4
EPAISSEUR | 1 | 92,59 | 3,70 | 1 | 0 | 5
PERCAGE | 1 | 96,30 | 3,70 | 1 | 0 | 6
PROFIL | 1 | 100,00 | 3,70 | 1 | 0 | 7
