MOUNAlae/dai-comp-001-duct-air-inlet/cfd/results/M2_01_contour_yplus_paroi.png

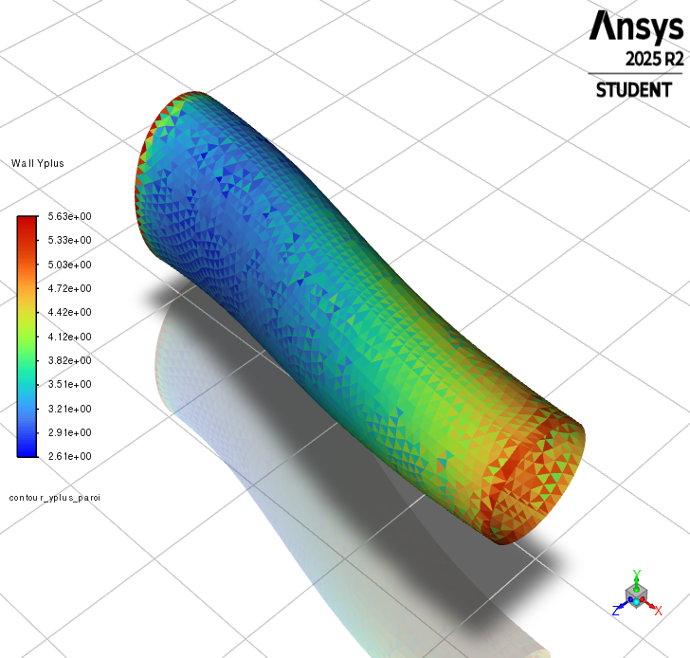
cfd/results/M2_01_contour_yplus_paroi.png
