MOUNAlae/dai-comp-001-duct-air-inlet/cfd/results/M2_02_contour_pression_totale_longitudinale.png

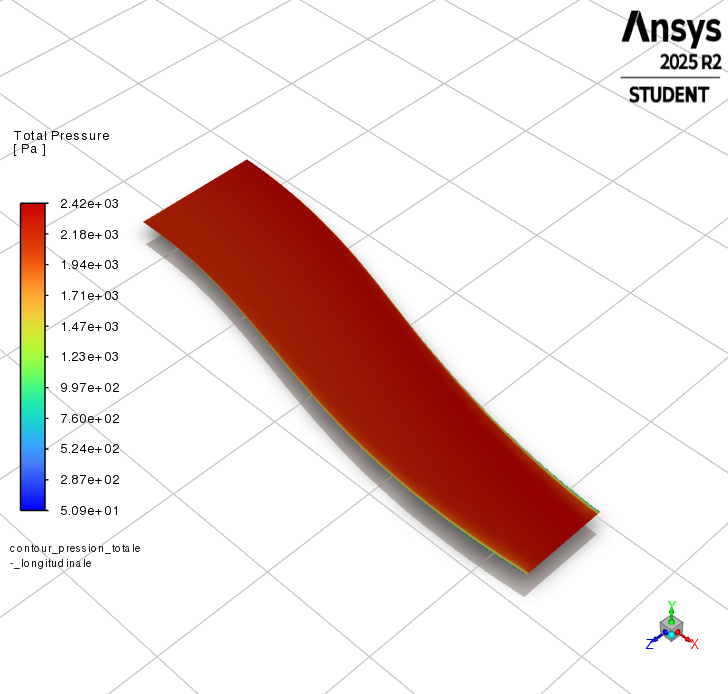
cfd/results/M2_02_contour_pression_totale_longitudinale.png
