MOUNAlae/dai-comp-001-duct-air-inlet/cfd/results/M2_05_vecteurs_vitesse_longitudinal.png

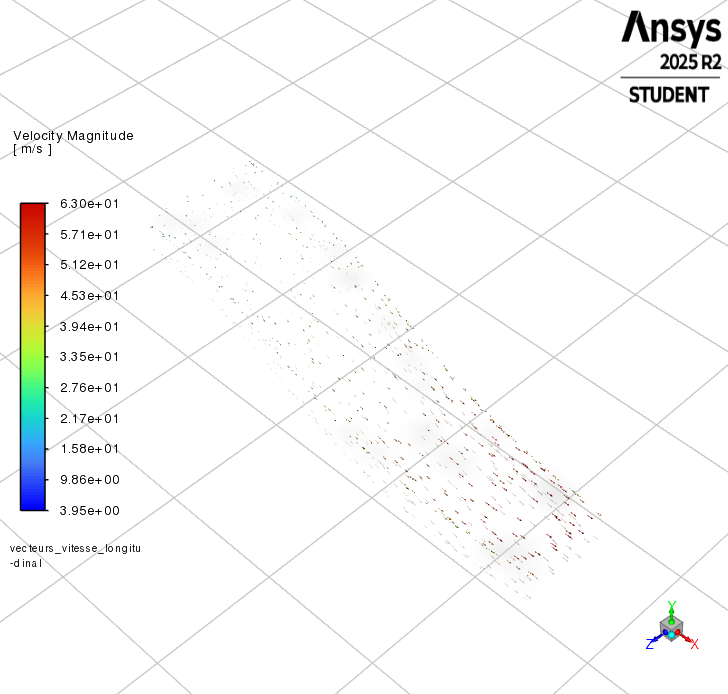
cfd/results/M2_05_vecteurs_vitesse_longitudinal.png
