MOUNAlae/dai-comp-001-duct-air-inlet/cfd/results/M2_06_lignes_courant_entree.png

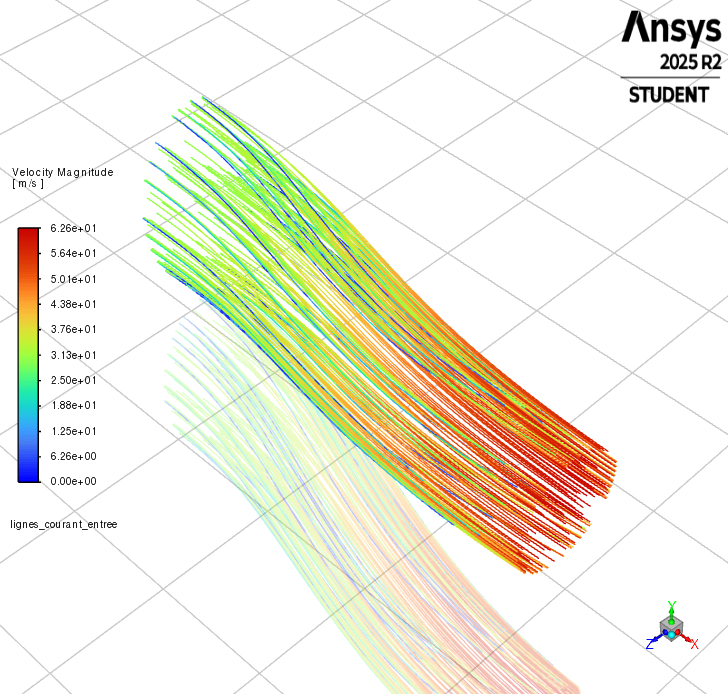
cfd/results/M2_06_lignes_courant_entree.png
