MOUNAlae/dai-comp-001-duct-air-inlet/docs/DAI-COMP-001_ASSEMBLY_FINAL_DRAWING.pdf

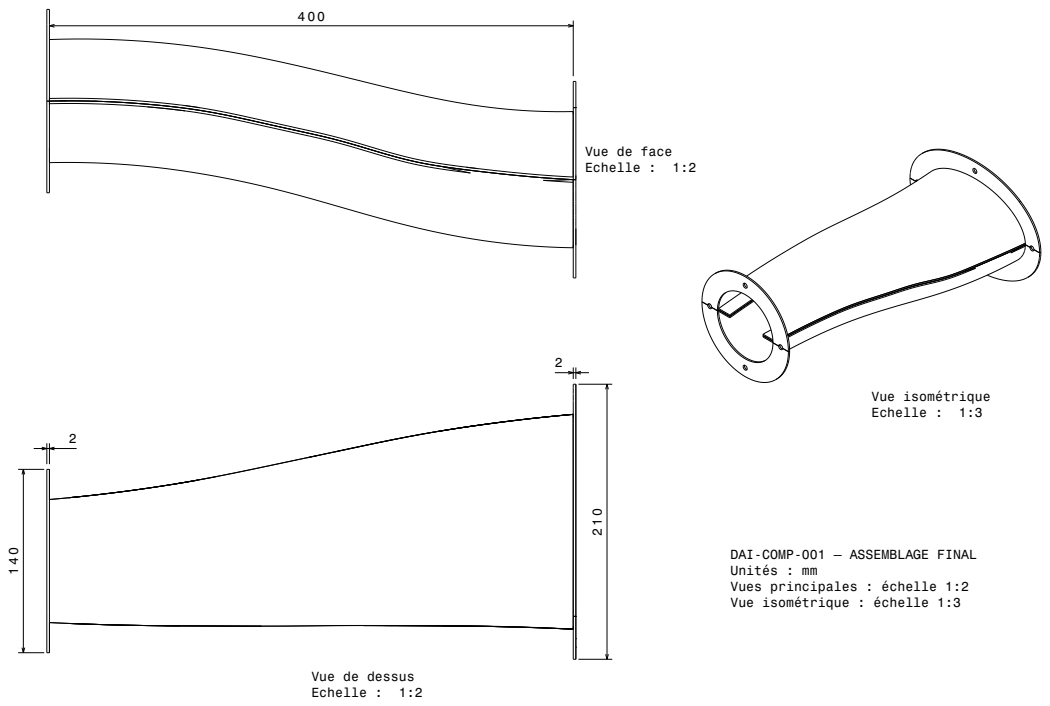
[picture p23: page 1]
Vue isométrique Echelle : 1:3

Vue de face
Echelle : 1:2

DAI-COMP-001 — ASSEMBLAGE FINAL
Unités : mm
Vues principales : échelle 1:2
Vue isométrique : échelle 1:3

Vue de dessus
