MOUNAlae/dai-comp-001-duct-air-inlet/(commit log)

2026-07-29 cad: ajout des modèles CATIA et du domaine fluide
    [DAI-COMP-001-FLUID-DOMAIN.stp, DAI-COMP-001-LOWER.CATPart, DAI-COMP-001-SKELETON.CATPart, DAI-COMP-001-UPPER.CATPart]
2026-07-29 cad: ajout de l’assemblage CATProduct final
    [DAI-COMP-001-ASSEMBLY.CATProduct]
2026-07-29 cad: restauration de la mise en plan finale
2026-07-29 cfd: ajout des résultats finaux du cas M2
2026-07-29 cfd: correction de la structure des résultats M2
2026-07-29 quality: ajout des scripts Python reproductibles
2026-07-29 quality: ajout du dataset synthétique du procédé
    [DAI_COMP_001_Dataset_Synthetique.csv]
2026-07-29 quality: ajout des synthèses Pareto MSA SPC et capabilité
    [DAI_COMP_001_Capabilite_Synthese.csv, DAI_COMP_001_MSA_Synthese.csv, DAI_COMP_001_Pareto_Defauts.csv, DAI_COMP_001_SPC_Synthese.csv, DAI_COMP_001_Synthese_Conformite.csv]
2026-07-29 quality: ajout du dashboard KPI et de la synthèse finale
    [DAI_COMP_001_Dashboard_KPI.csv, DAI_COMP_001_Synthese_Finale.csv]
2026-07-29 quality: ajout du classeur Excel final d’analyse
    [DAI_COMP_001_Analyse_Qualite_Final.xlsx]
2026-07-29 docs: ajout des visuels CATIA du projet
2026-07-29 docs: correction de la structure du dépôt dans le README
2026-07-29 docs: correction finale de l’arborescence du README
2026-07-29 docs: correction du symbole dans l’arborescence
2026-07-29 docs: ajout des liens vers les livrables principaux
